dhalperi/BulbDialKit/beedyschem.pdf

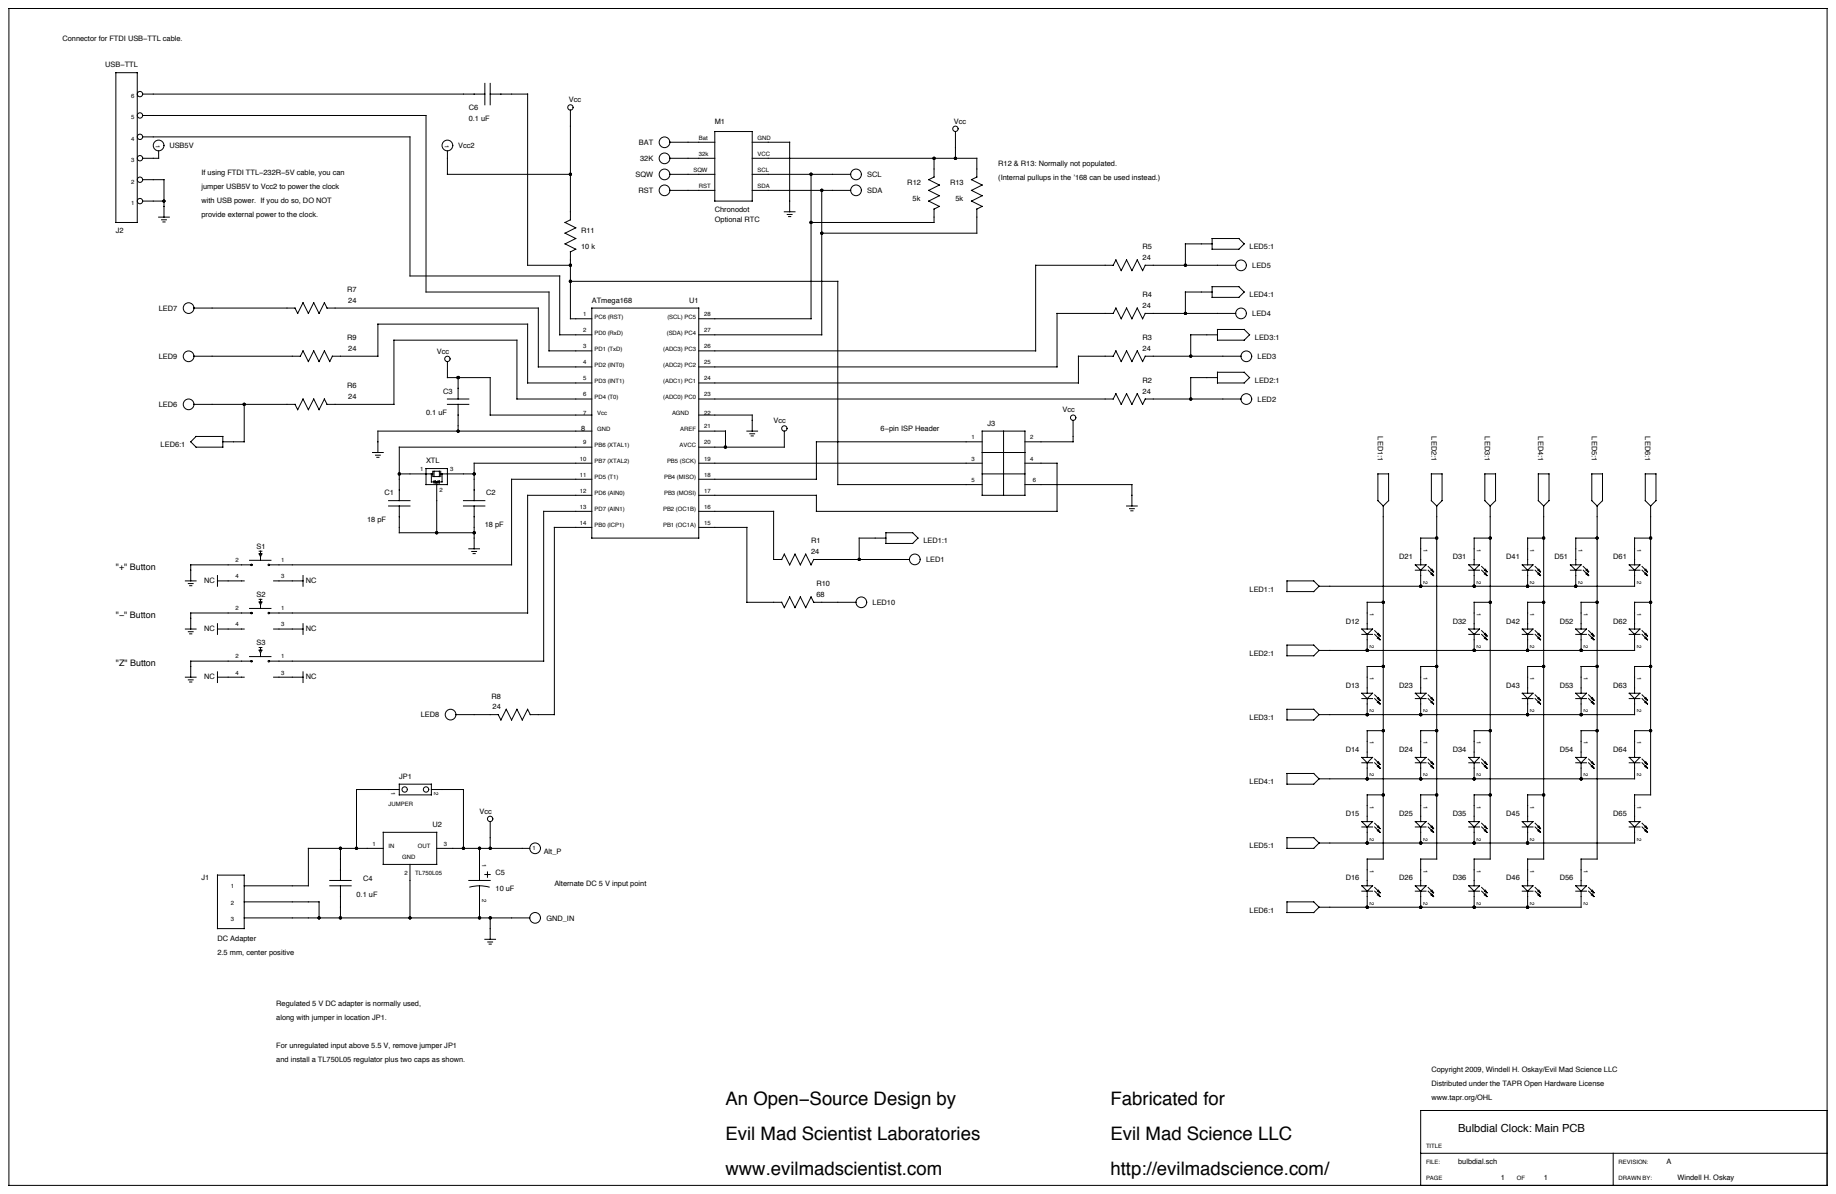
[picture p1: page 1]

Connector for FTDI USBïTTL cable.

If using FTDI TTLï232Rï5V cable, you can
jumper USB5V to Vcc2 to power the clock
with USB power. If you do so, DO NOT
provide external power to the clock.

R12 & R13: Normally not populated.
(Internal pullups in the ’168 can be used instead.)

Alternate DC 5 V input point

Regulated 5 V DC adapter is normally used,
along with jumper in location JP1.

For unregulated input above 5.5 V, remove jumper JP1
and install a TL750L05 regulator plus two caps as shown.

Copyright 2009, Windell H. Oskay/Evil Mad Science LLC
Distributed under the TAPR Open Hardware License
www.tapr.org/OHL

An OpenïSource Design by
Evil Mad Scientist Laboratories
www.evilmadscientist.com

Fabricated for
Evil Mad Science LLC
http://evilmadscience.com/

Bulbdial Clock: Main PCB

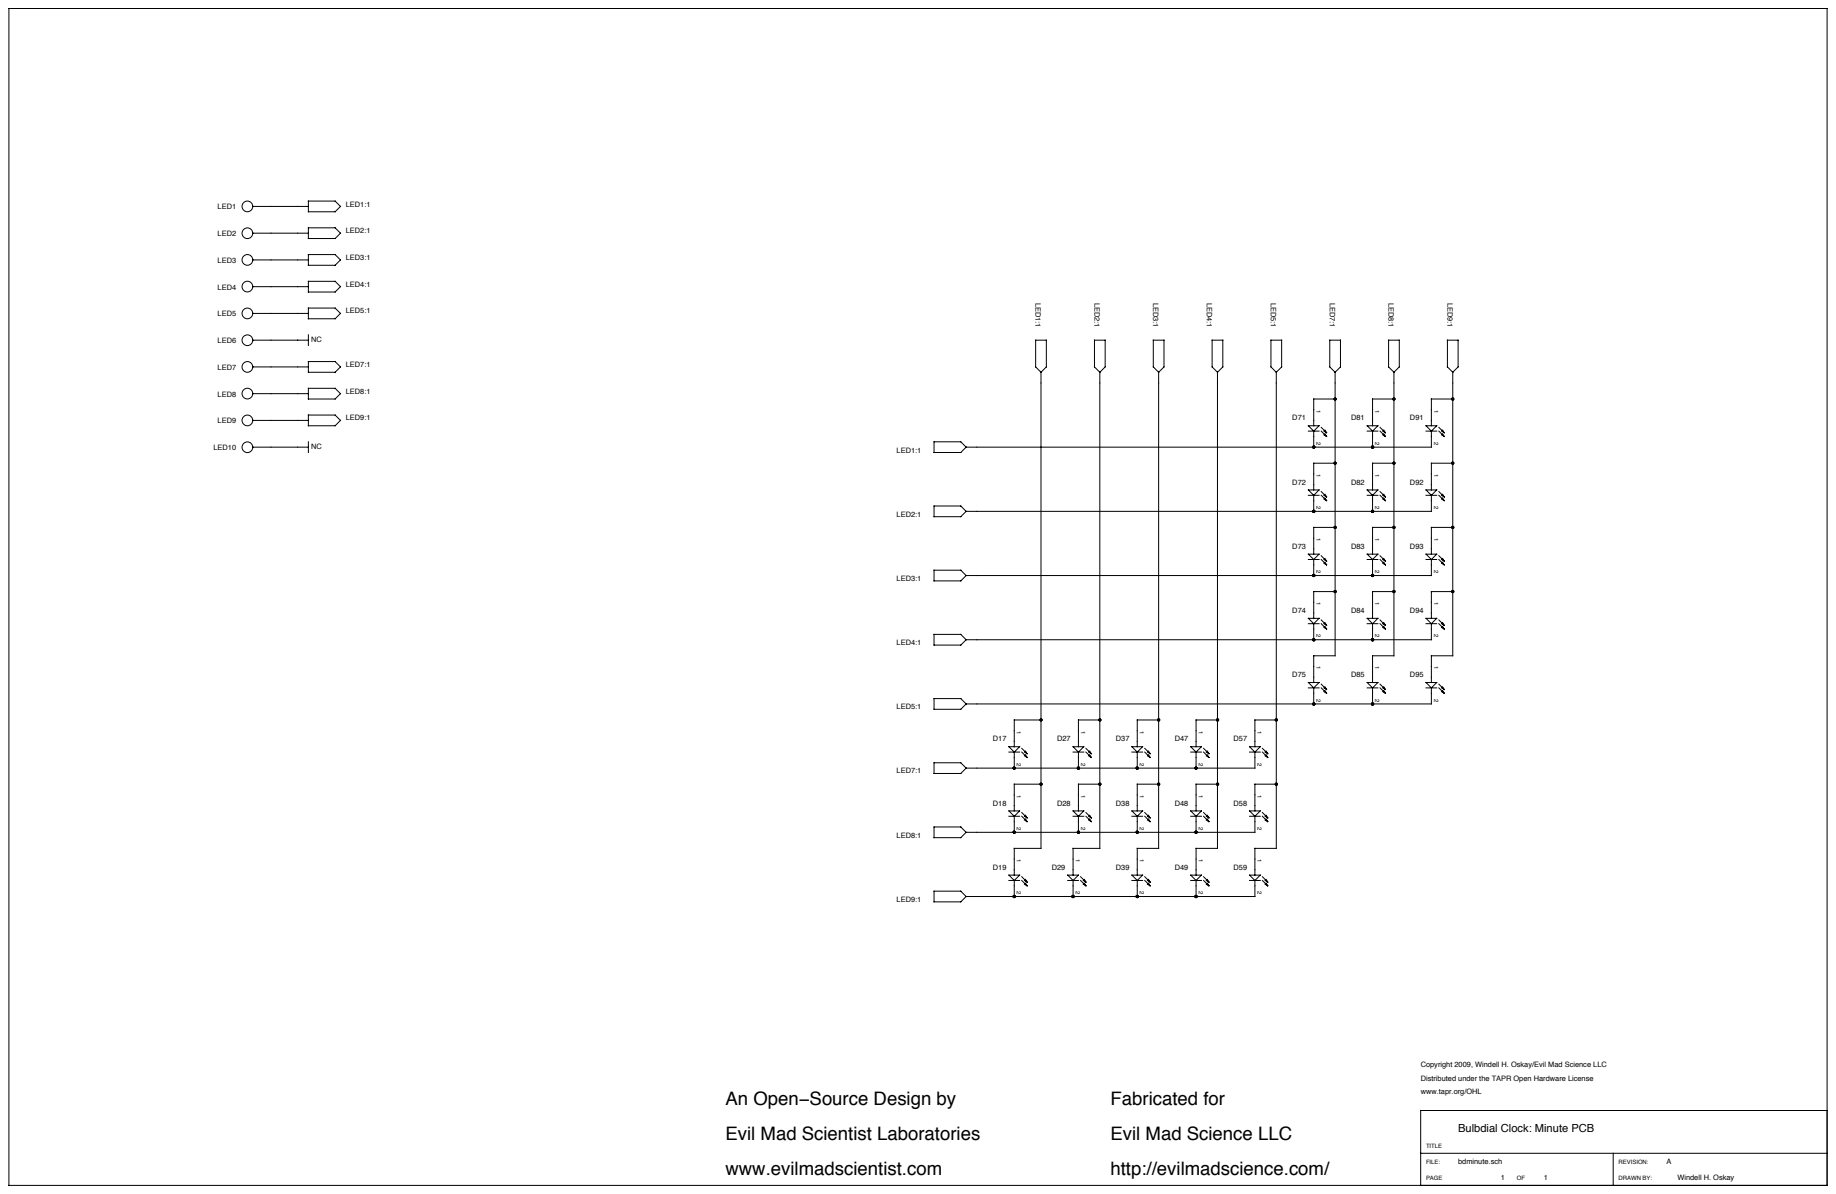
[picture p2: page 2]
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

An OpenïSource Design by
Evil Mad Scientist Laboratories
www.evilmadscientist.com

Fabricated for
Evil Mad Science LLC
http://evilmadscience.com/

Bulbdial Clock: Minute PCB

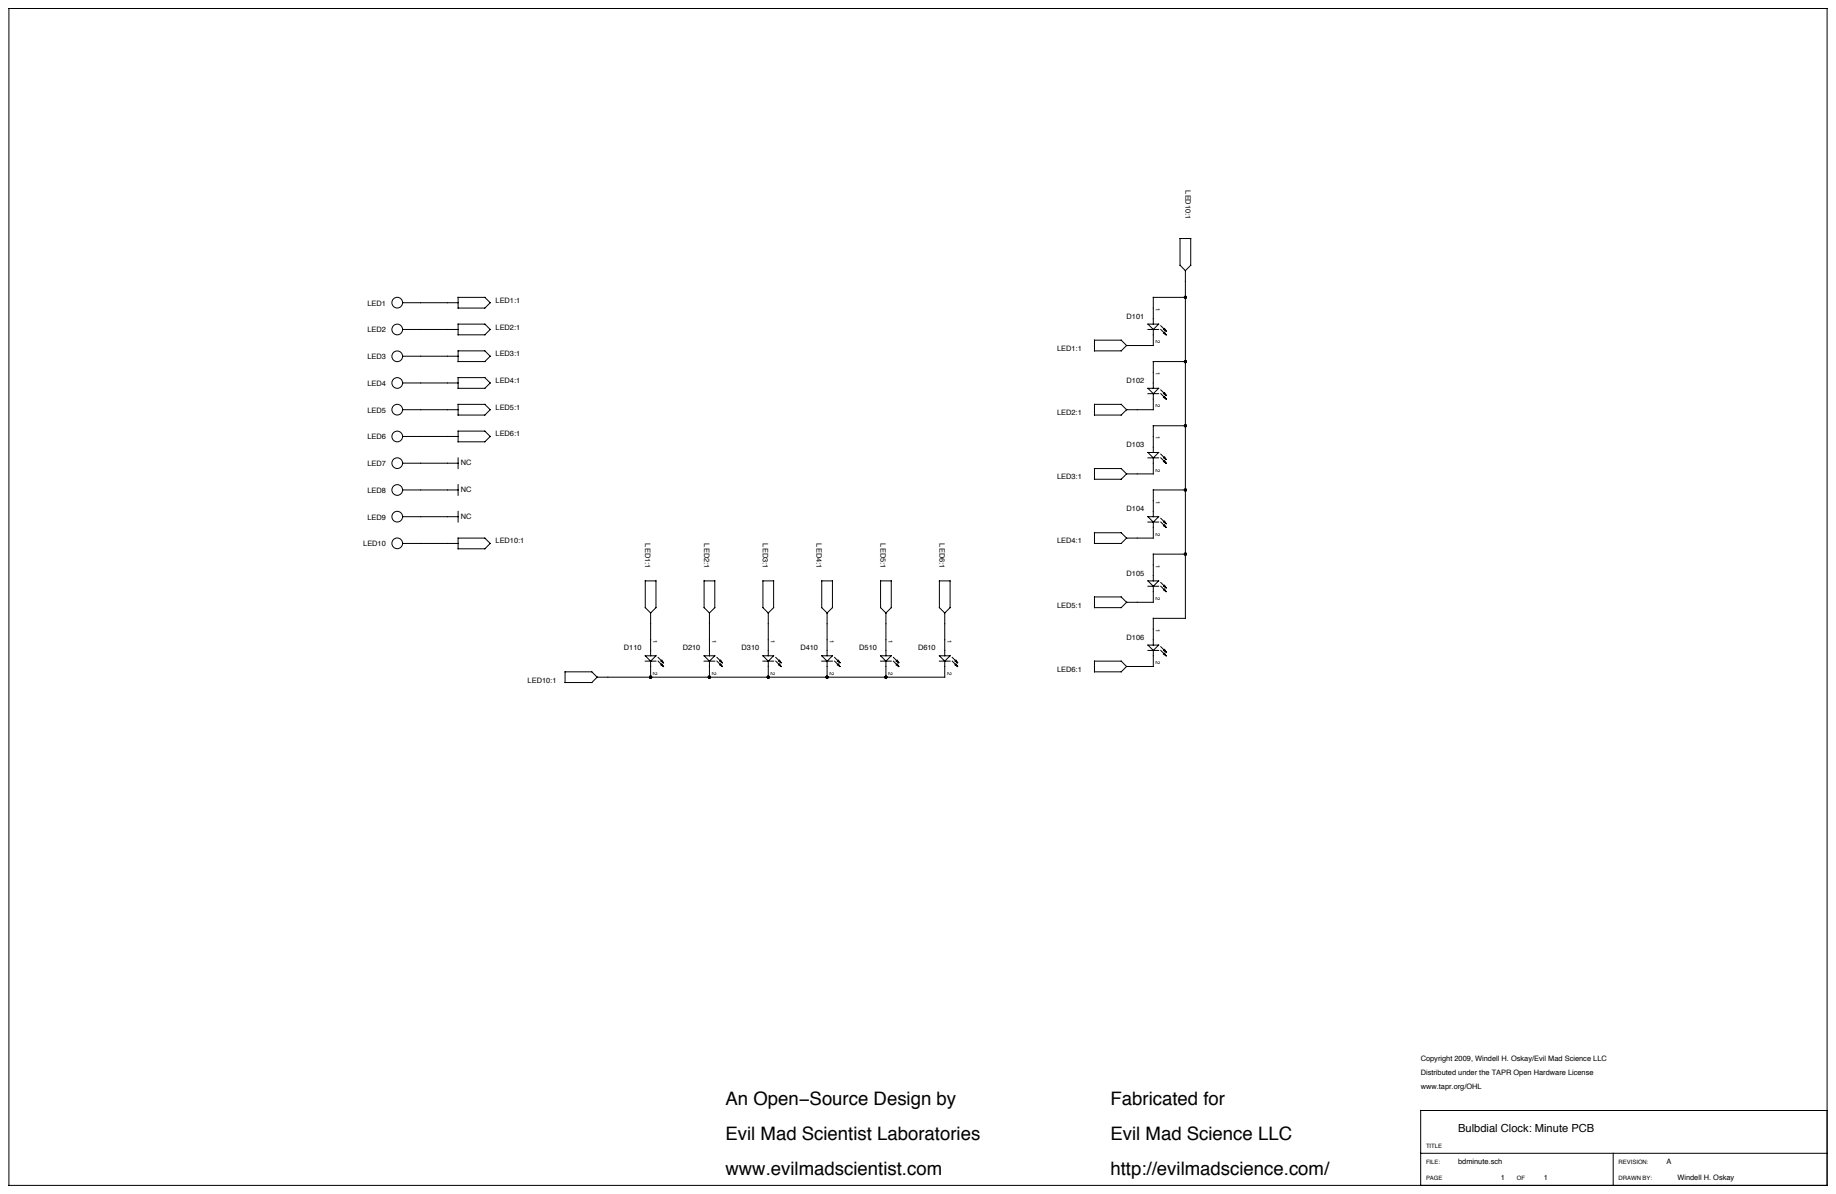
[picture p3: page 3]
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

An OpenïSource Design by
Evil Mad Scientist Laboratories
www.evilmadscientist.com

Fabricated for
Evil Mad Science LLC
http://evilmadscience.com/

Bulbdial Clock: Minute PCB
